Kanaphat4539/Security_Door_Lock/hardware/mainboard-min-handmade/JUMPERS.md

# Jumper wire list (single-sided build)

หลังกัดทองแดง F.Cu แล้ว ให้เดินสายไฟหุ้มฉนวนด้านบนบอร์ด (B.Cu)
ตามรายการนี้ สายกระโดดข้ามกันได้ (หุ้มฉนวน). จุดที่เป็น SMD pad
มีรูเจาะ (via) ให้ร้อยสายลงไปเชื่อม F.Cu.

| # | net | from | to | หมายเหตุ |
|---|-----|---|----|---|
| 1 | RFID_ENTRY_MOSI | U1.30 | J3.3 | เดินอ้อม |
| 2 | RELAY_CTRL | U1.9 | J8.3 | เดินอ้อม |
| 3 | CAM_RX2 | U1.21 | J7.4 | เดินอ้อม |
| 4 | RFID_EXIT_MOSI | U1.13 | J4.3 | สายตรง (ข้ามสายอื่น) |
| 5 | RFID_EXIT_SCK | U1.11 | J4.2 | สายตรง (ข้ามสายอื่น) |
| 6 | CAM_TX2 | U1.22 | J7.3 | เดินอ้อม |
| 7 | RFID_ENTRY_SS | U1.23 | J3.1 | สายตรง (ข้ามสายอื่น) |
| 8 | RFID_EXIT_MISO | U1.5 | J4.4 | สายตรง (ข้ามสายอื่น) |
| 9 | US_ECHO_3V3 | U1.6 | R6.2 | สายตรง (ข้ามสายอื่น) + via 1 จุด |
| 10 | +5V | U1.15 | J9.1 | สายตรง (ข้ามสายอื่น) |
| 11 | US_TRIG | U1.7 | J6.2 | สายตรง (ข้ามสายอื่น) |
| 12 | RFID_ENTRY_RST | U1.10 | J3.7 | สายตรง (ข้ามสายอื่น) |
| 13 | +5V | U1.15 | J6.1 | เดินอ้อม |
| 14 | BUZZER_CTRL | U1.8 | R8.1 | สายตรง (ข้ามสายอื่น) + via 1 จุด |
