Kanaphat4539/Security_Door_Lock/hardware/mainboard-min-handmade/handmade_top.png

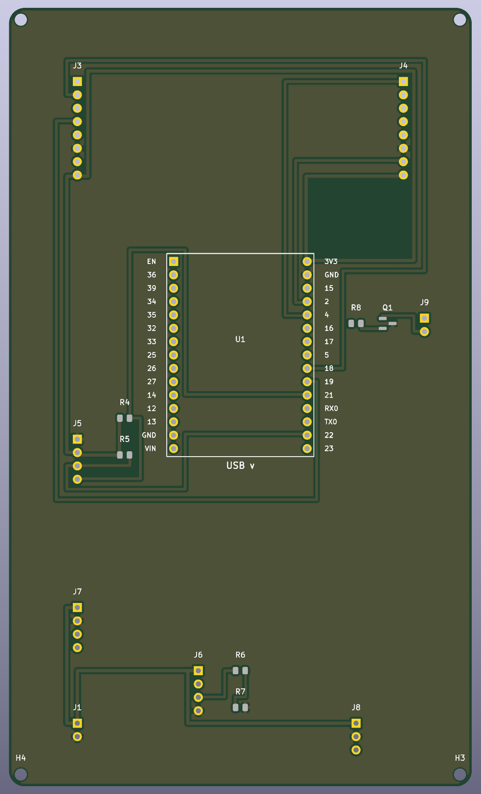
hardware/mainboard-min-handmade/handmade_top.png
