Kanaphat4539/Security_Door_Lock/hardware/mainboard-min-routed/routed_top.png

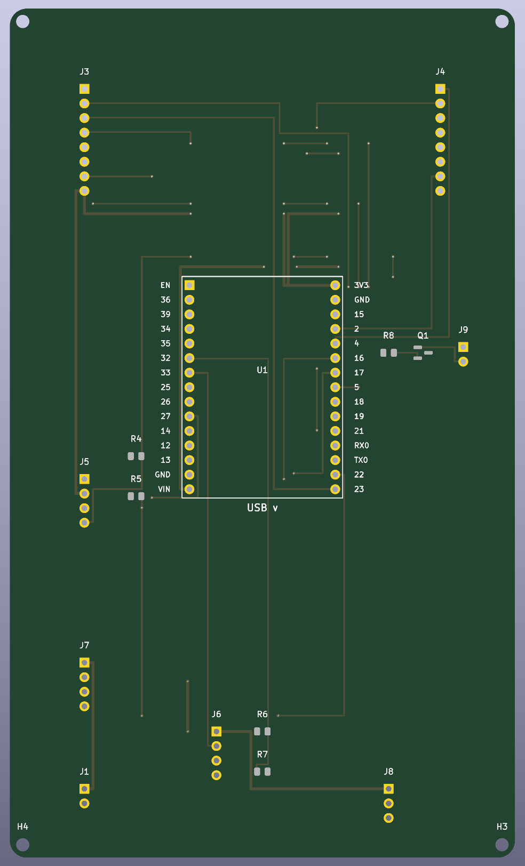
hardware/mainboard-min-routed/routed_top.png
