Kanaphat4539/Security_Door_Lock/hardware/mainboard/crop_power.png

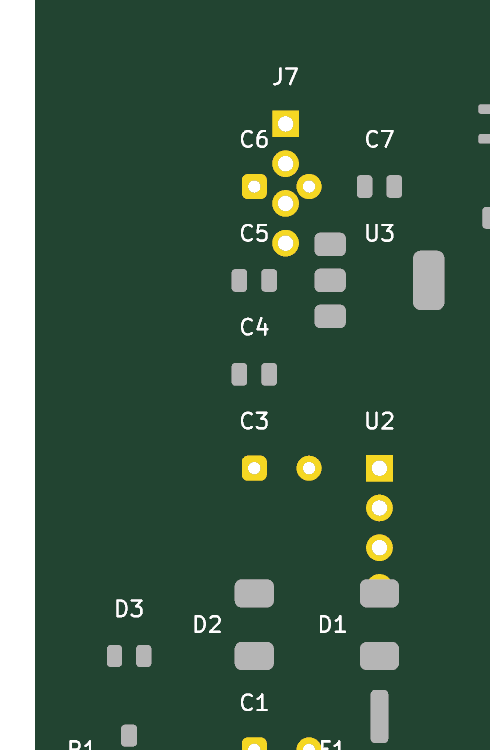
hardware/mainboard/crop_power.png
