Kanaphat4539/Security_Door_Lock/hardware/mainboard/crop_relay.png

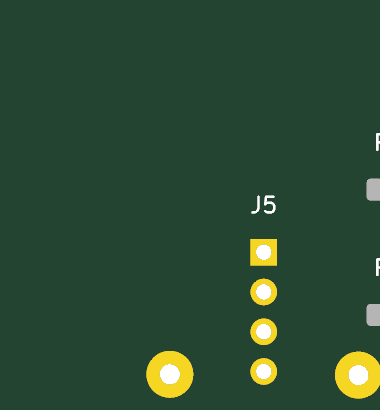
hardware/mainboard/crop_relay.png
