Kanaphat4539/Security_Door_Lock/hardware/mainboard/crop_right.png

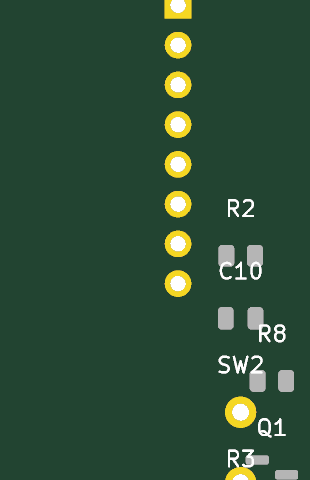
hardware/mainboard/crop_right.png
