Kanaphat4539/Security_Door_Lock/hardware/mainboard/placement_check.png

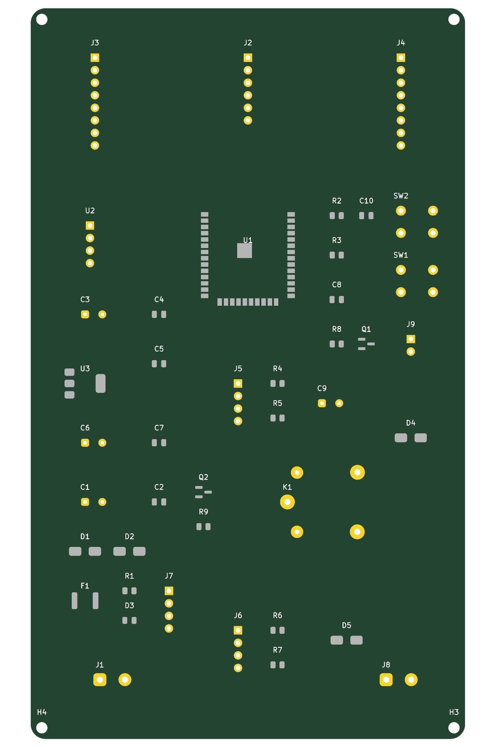
hardware/mainboard/placement_check.png
