Kanaphat4539/Security_Door_Lock/hardware/mainboard/routed_top.png

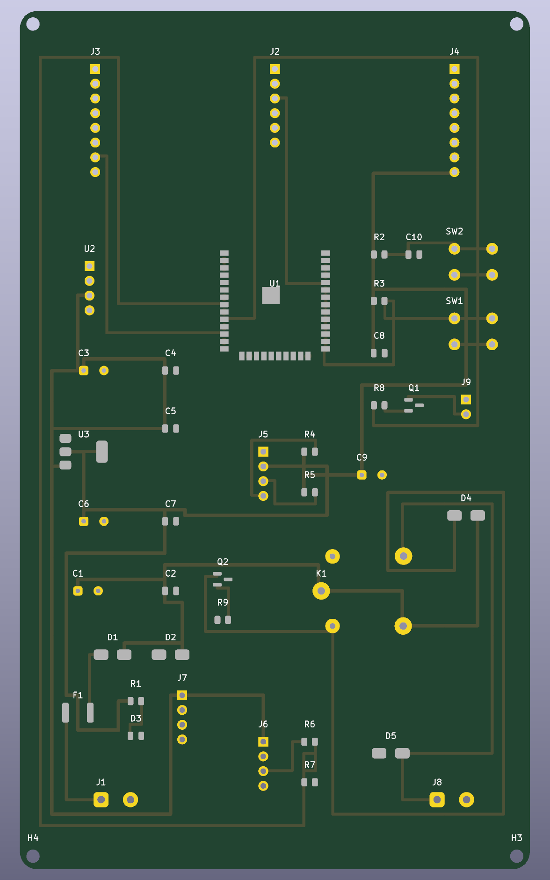
hardware/mainboard/routed_top.png
