Kanaphat4539/Security_Door_Lock/hardware_test_results.xlsx

Sheet: คำอธิบาย
ตารางผลการทดลองฮาร์ดแวร์ — ระบบล็อกประตูอัจฉริยะ RFID + กล้อง IoT
วิธีคำนวณค่าความผิดพลาด (Err %)
Err % = ( จำนวนครั้งที่ผิดพลาด ÷ จำนวนครั้งที่ทดสอบทั้งหมด ) × 100
โดย จำนวนครั้งที่ผิดพลาด = จำนวนครั้งที่ทดสอบทั้งหมด (N) − จำนวนครั้งที่สำเร็จ
ตัวอย่าง : ทดสอบ 10 ครั้ง สำเร็จ 9 ครั้ง → ผิดพลาด = 10 − 9 = 1 → Err % = 1/10 × 100 = 10.0%
• กรอกเฉพาะช่องสีเหลือง 2 ช่อง คือ "ครั้งทดสอบ (N)" และ "สำเร็จ"
• ช่อง "ผิดพลาด" และ "Err %" คำนวณให้อัตโนมัติด้วยสูตร (ห้ามพิมพ์ทับ)
• แนะนำทดสอบอย่างน้อย 10 ครั้ง/แถว (RFID และ End-to-end แนะนำ 20–30 ครั้ง) เพื่อให้ % น่าเชื่อถือ
• แถวรวมท้ายตาราง = ผลรวมทุกขั้นของกรณีนั้น (Err% รวม = Σผิดพลาด ÷ ΣN)
สัญลักษณ์สี
ช่องกรอกเอง (input) | #NAME?
ตัวอย่างการกรอก (แถวสาธิต — ไม่ใช่ข้อมูลจริง)
อุปกรณ์ | ครั้งทดสอบ (N) | สำเร็จ | ผิดพลาด | Err %
RFID #1 (สาธิต) | 10 | 9 | 1 | 10.0%

Sheet: 1_ขาเข้า-บัตรผ่าน
กรณีที่ 1 : ฝั่งขาเข้า (Entry) — บัตรผ่าน (granted)
ลำดับ | อุปกรณ์ | Input | Output ที่คาดหวัง | ครั้งทดสอบ (N) | สำเร็จ | ผิดพลาด | Err %
1 | Ultrasonic HY-SRF05 | เข้าใกล้ 100 cm (ระยะปลุกจอ) | WAKE → สั่งกล้องเปิด
2 | ESP32-CAM (จอ TFT) | คำสั่ง WAKE | เปิดจอ ST7735S + สตรีมภาพสด
3 | RFID RC522 #1 (เข้า) | ทาบบัตรที่ลงทะเบียน | อ่าน UID ถูกต้อง → ส่ง direction:in
4 | Backend /access | รับ JSON {uid, in} | ตอบ granted
5 | ESP32-CAM (/capture) | backend ดึงรูป | คืนไฟล์ JPEG ไม่เสีย
6 | OLED SH1106 | — | แสดงข้อความ "อนุญาต"
7 | Buzzer | — | เสียงสั้น 0.2 วินาที
8 | Relay + Solenoid Lock | — | ปลดล็อก 5 วินาที → ล็อกกลับ
9 | Dashboard (เรียลไทม์) | — | log + รูปขึ้นหน้าจอทันที
รวม |  |  |  | 0 | 0 | 0

Sheet: 2_ขาเข้า-บัตรไม่ผ่าน
กรณีที่ 2 : ฝั่งขาเข้า (Entry) — บัตรไม่ผ่าน (denied)
ลำดับ | อุปกรณ์ | Input | Output ที่คาดหวัง | ครั้งทดสอบ (N) | สำเร็จ | ผิดพลาด | Err %
1 | RFID RC522 #1 (เข้า) | ทาบบัตรแปลก/ปิดใช้งาน | อ่าน UID → ส่ง direction:in
2 | Backend /access | รับ JSON {uid, in} | ตอบ denied
3 | ESP32-CAM (/capture) | backend ดึงรูป | คืน JPEG เก็บเป็นหลักฐาน
4 | OLED SH1106 | — | แสดงข้อความ "ไม่อนุญาต"
5 | Buzzer | — | เสียงยาว 3 วินาที
6 | Relay + Solenoid Lock | — | คงสถานะล็อก (ประตูไม่เปิด)
7 | Dashboard (เรียลไทม์) | — | log สถานะ denied + รูปหลักฐาน
รวม |  |  |  | 0 | 0 | 0

Sheet: 3_ขาออก-บัตรผ่าน
กรณีที่ 3 : ฝั่งขาออก (Exit) — บัตรผ่าน (granted)
ลำดับ | อุปกรณ์ | Input | Output ที่คาดหวัง | ครั้งทดสอบ (N) | สำเร็จ | ผิดพลาด | Err %
1 | RFID RC522 #2 (ออก) | ทาบบัตรที่ลงทะเบียน | อ่าน UID → direction:out (ไม่ถ่ายรูป)
2 | Backend /access | รับ JSON {uid, out} | ตอบ granted (ไม่ดึงรูป)
3 | Buzzer | — | เสียงสั้น 1 ครั้ง
4 | Relay + Solenoid Lock | — | ปลดล็อก 5 วินาที → ล็อกกลับ
5 | Dashboard (เรียลไทม์) | — | log direction:out, imageUrl = null
รวม |  |  |  | 0 | 0 | 0

Sheet: 4_ขาออก-บัตรไม่ผ่าน
กรณีที่ 4 : ฝั่งขาออก (Exit) — บัตรไม่ผ่าน (denied)
ลำดับ | อุปกรณ์ | Input | Output ที่คาดหวัง | ครั้งทดสอบ (N) | สำเร็จ | ผิดพลาด | Err %
1 | RFID RC522 #2 (ออก) | ทาบบัตรแปลก/ปิดใช้งาน | อ่าน UID → ส่ง direction:out
2 | Backend /access | รับ JSON {uid, out} | ตอบ denied + เก็บ log
3 | Buzzer | — | เสียงยาว
4 | Relay + Solenoid Lock | — | คงสถานะล็อก
5 | Dashboard (เรียลไทม์) | — | log สถานะ denied, out
รวม |  |  |  | 0 | 0 | 0

Sheet: สรุปผล
สรุปผลการทดลอง 4 กรณี
กรณี | ทิศทาง | ผลบัตร | ผลลัพธ์ที่ต้องได้ | ครั้งทดสอบ | Err % รวม
1 | ขาเข้า | ผ่าน | ประตูเปิด + บันทึกรูป | 0
2 | ขาเข้า | ไม่ผ่าน | ประตูล็อก + เก็บรูปหลักฐาน | 0
3 | ขาออก | ผ่าน | ประตูเปิด (ไม่มีรูป) | 0
4 | ขาออก | ไม่ผ่าน | ประตูล็อก | 0
รวมทั้งหมด |  |  |  | 0
หมายเหตุ: Err % รวม = ผลรวมจำนวนครั้งที่ผิดพลาดทุกขั้น ÷ ผลรวมจำนวนครั้งที่ทดสอบทั้งหมด × 100
