Kanaphat4539/Security_Door_Lock/hardware/mainboard-min-handmade/PLACEMENT_guide.pdf

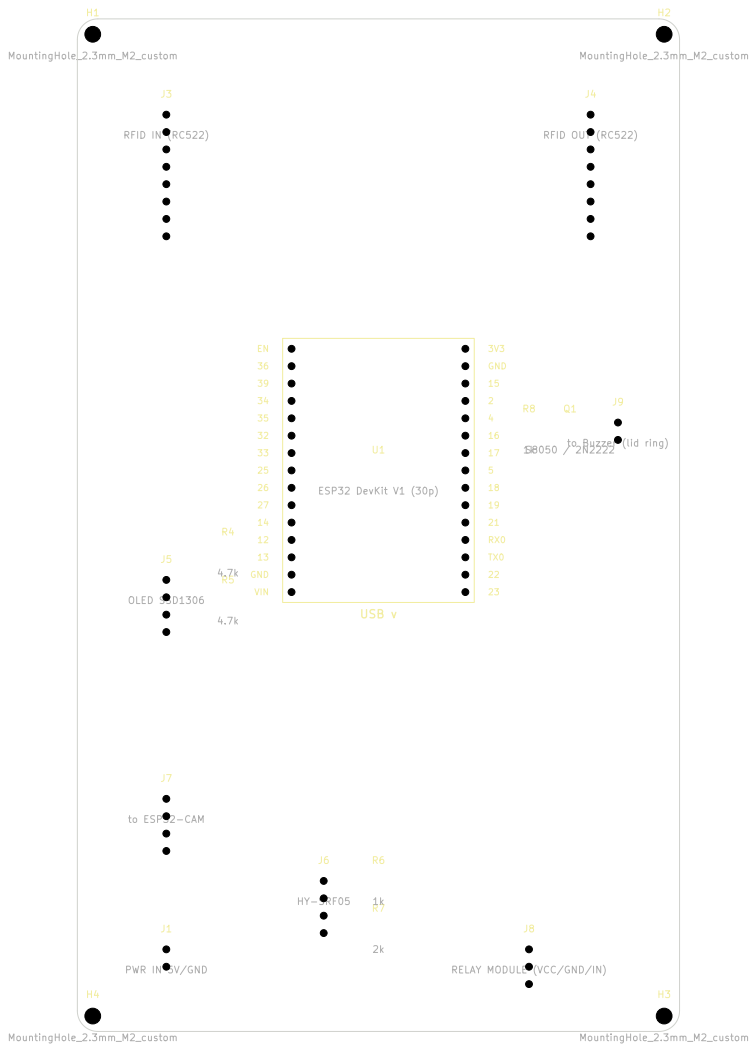
[picture p8: page 1]

RELAY MODULE (VCC/GND/IN) MountingHole_2.3mm_M2_custom
