Kanaphat4539/Security_Door_Lock/hardware/mainboard-min-handmade/copper_normal.pdf

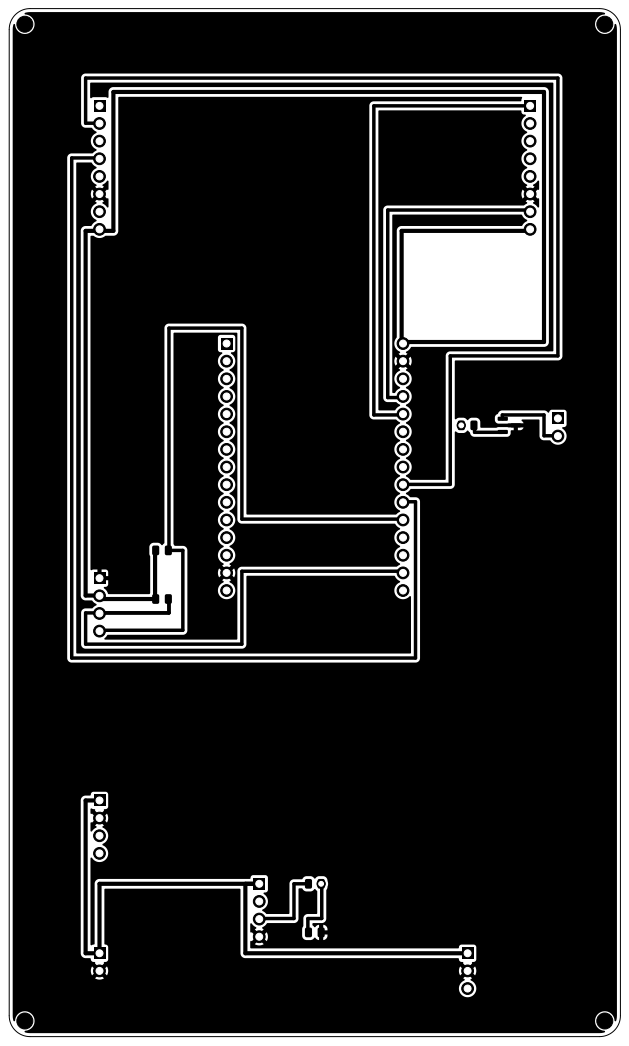
[picture p9: page 1]
