Kanaphat4539/Security_Door_Lock/hardware/mainboard-min-handmade/ETCH_copper_mirrored.pdf

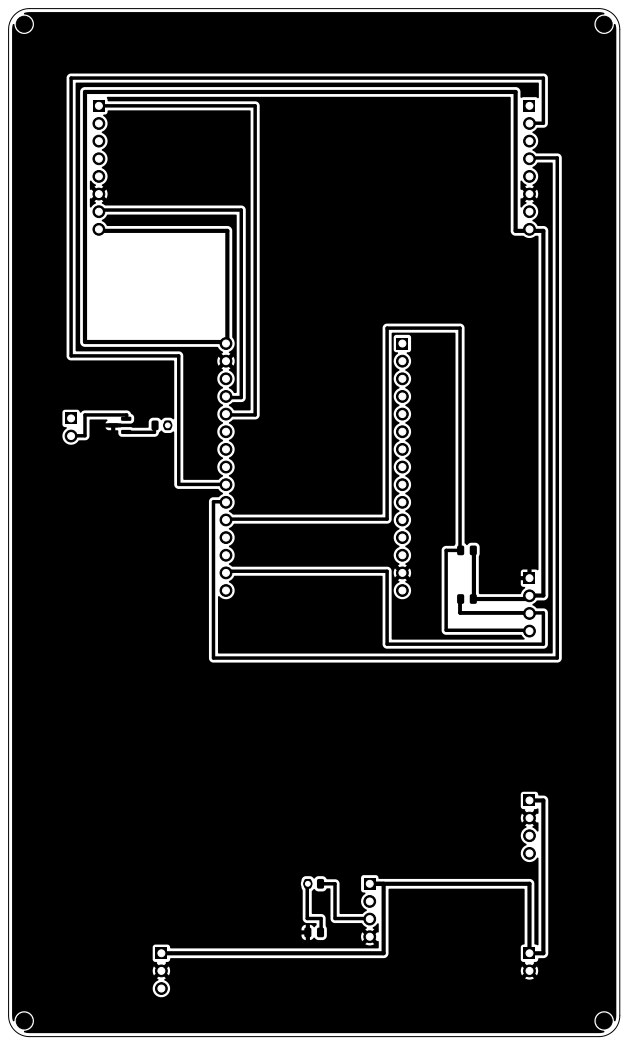
[picture p10: page 1]
