Kanaphat4539/Security_Door_Lock/hardware/mainboard-min-handmade/mainboard.kicad_pcb

## KiCad design hardware/mainboard-min-handmade/mainboard.kicad_pcb (2026-10-06)

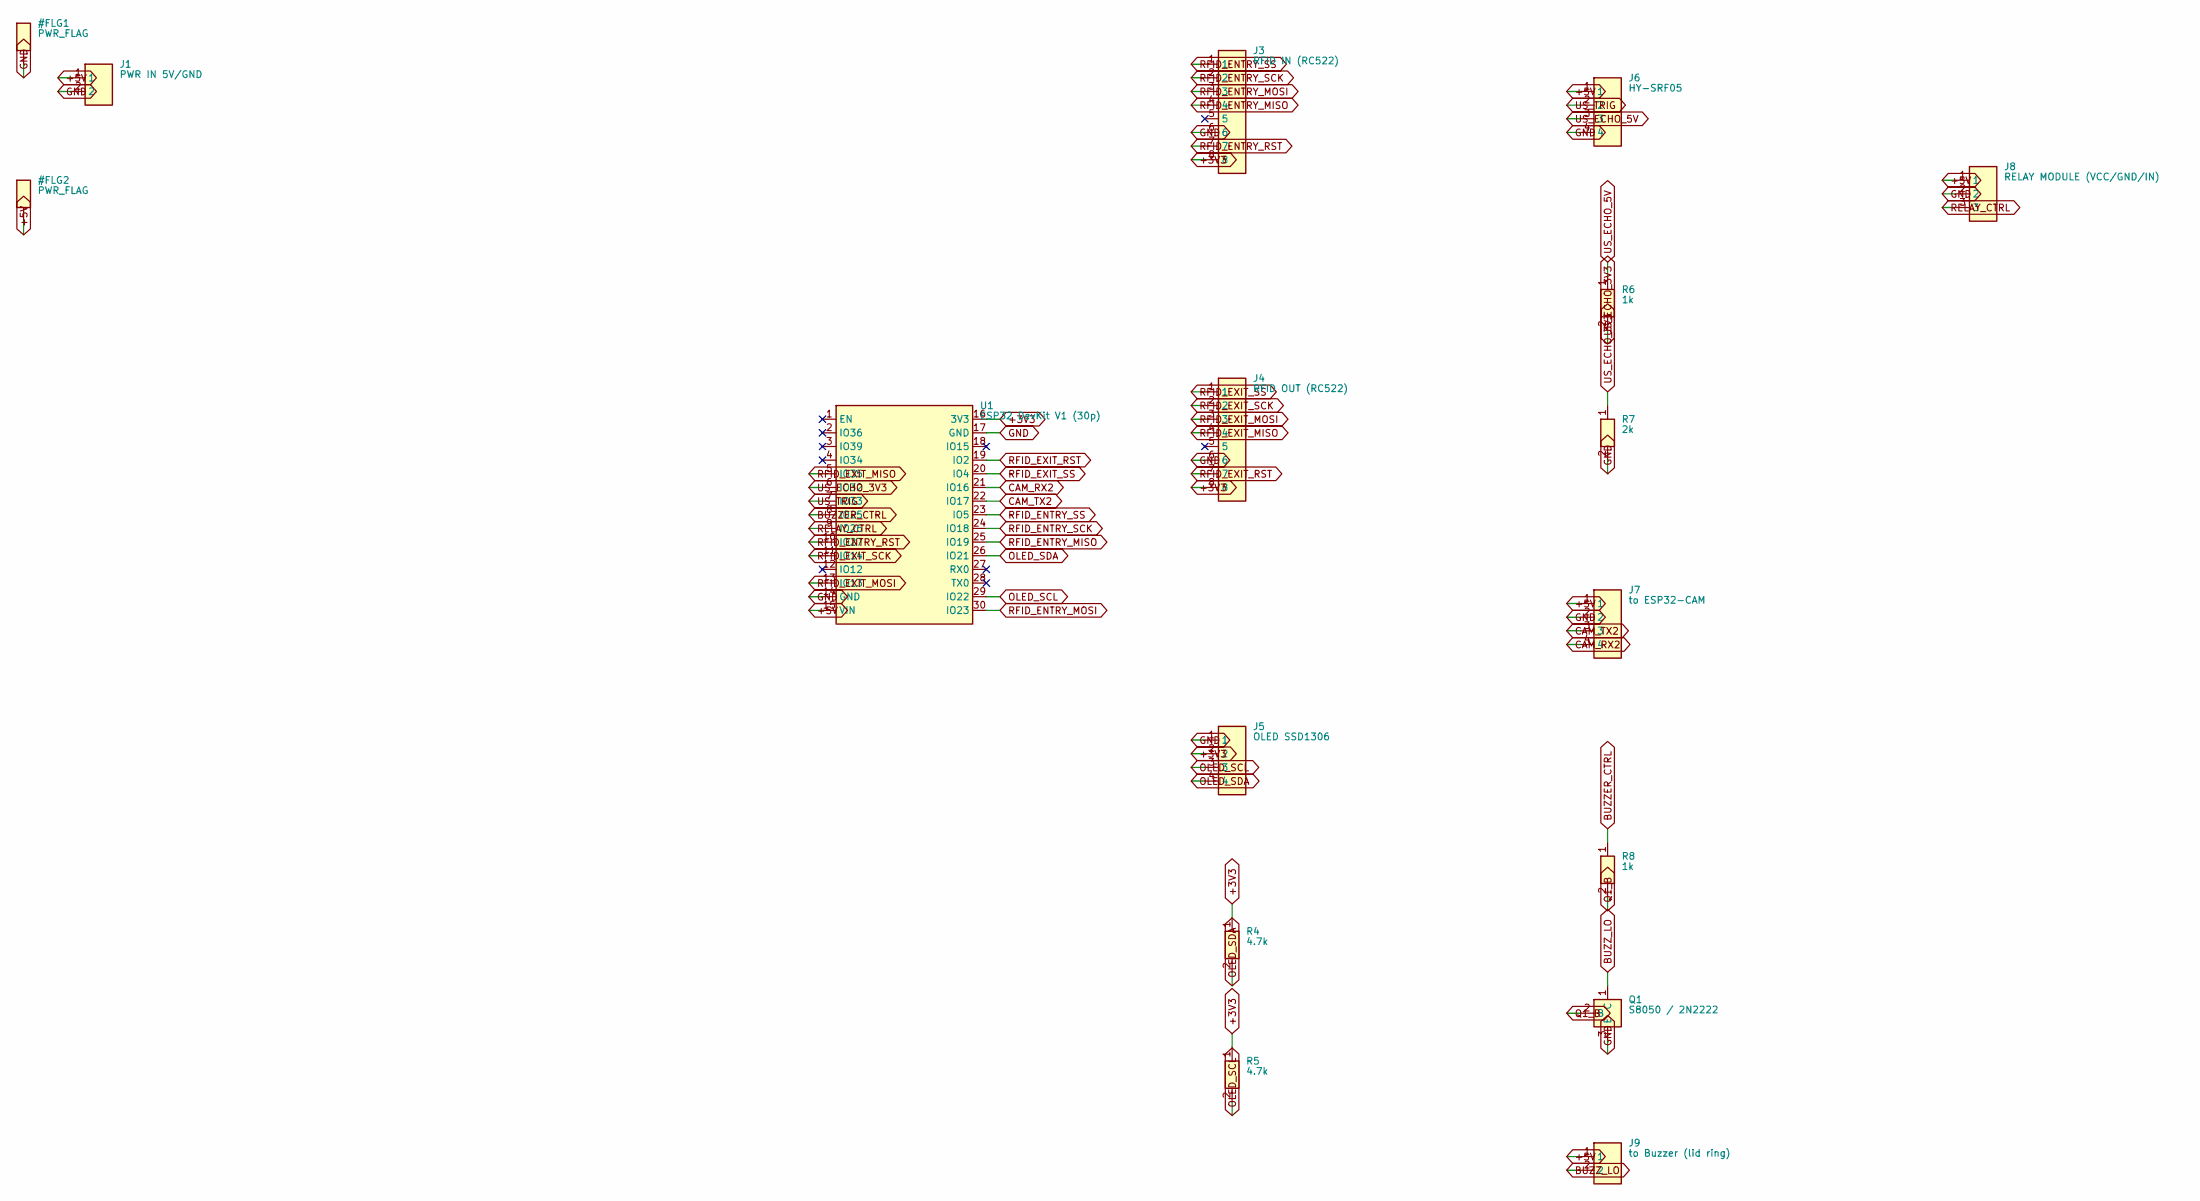
[picture p11: schematic mainboard.kicad_sch, Security Door Lock - Mainboard (ESP32 hub)]

Parts:
J1: PWR IN 5V/GND; PinHeader_1x02_P2.54mm_Vertical
J3: RFID IN (RC522); PinHeader_1x08_P2.54mm_Vertical
J4: RFID OUT (RC522); PinHeader_1x08_P2.54mm_Vertical
J5: OLED SSD1306; PinHeader_1x04_P2.54mm_Vertical
J6: HY-SRF05; PinHeader_1x04_P2.54mm_Vertical
J7: to ESP32-CAM; PinHeader_1x04_P2.54mm_Vertical
J8: RELAY MODULE (VCC/GND/IN); PinHeader_1x03_P2.54mm_Vertical
J9: to Buzzer (lid ring); PinHeader_1x02_P2.54mm_Vertical
Q1: S8050 / 2N2222; SOT-23
R4, R5: 4.7k; R_0805_2012Metric
R6, R8: 1k; R_0805_2012Metric
R7: 2k; R_0805_2012Metric
U1: ESP32 DevKit V1 (30p); ESP32-DevKitV1-30P_Socket

Connections:
+3V3: J3.8, J4.8, J5.2, R4.1, R5.1, U1.16 (3V3)
+5V: J1.1, J6.1, J7.1, J8.1, J9.1, U1.15 (VIN)
BUZZER_CTRL: R8.1, U1.8 (IO25)
BUZZ_LO: J9.2, Q1.1 (C)
CAM_RX2: J7.4, U1.21 (IO16)
CAM_TX2: J7.3, U1.22 (IO17)
GND: J1.2, J3.6, J4.6, J5.1, J6.4, J7.2, J8.2, Q1.3 (E), R7.2, U1.14 (GND), U1.17 (GND)
OLED_SCL: J5.3, R5.2, U1.29 (IO22)
OLED_SDA: J5.4, R4.2, U1.26 (IO21)
Q1_B: Q1.2 (B), R8.2
RELAY_CTRL: J8.3, U1.9 (IO26)
RFID_ENTRY_MISO: J3.4, U1.25 (IO19)
RFID_ENTRY_MOSI: J3.3, U1.30 (IO23)
RFID_ENTRY_RST: J3.7, U1.10 (IO27)
RFID_ENTRY_SCK: J3.2, U1.24 (IO18)
RFID_ENTRY_SS: J3.1, U1.23 (IO5)
RFID_EXIT_MISO: J4.4, U1.5 (IO35)
RFID_EXIT_MOSI: J4.3, U1.13 (IO13)
RFID_EXIT_RST: J4.7, U1.19 (IO2)
RFID_EXIT_SCK: J4.2, U1.11 (IO14)
RFID_EXIT_SS: J4.1, U1.20 (IO4)
US_ECHO_3V3: R6.2, R7.1, U1.6 (IO32)
US_ECHO_5V: J6.3, R6.1
US_TRIG: J6.2, U1.7 (IO33)

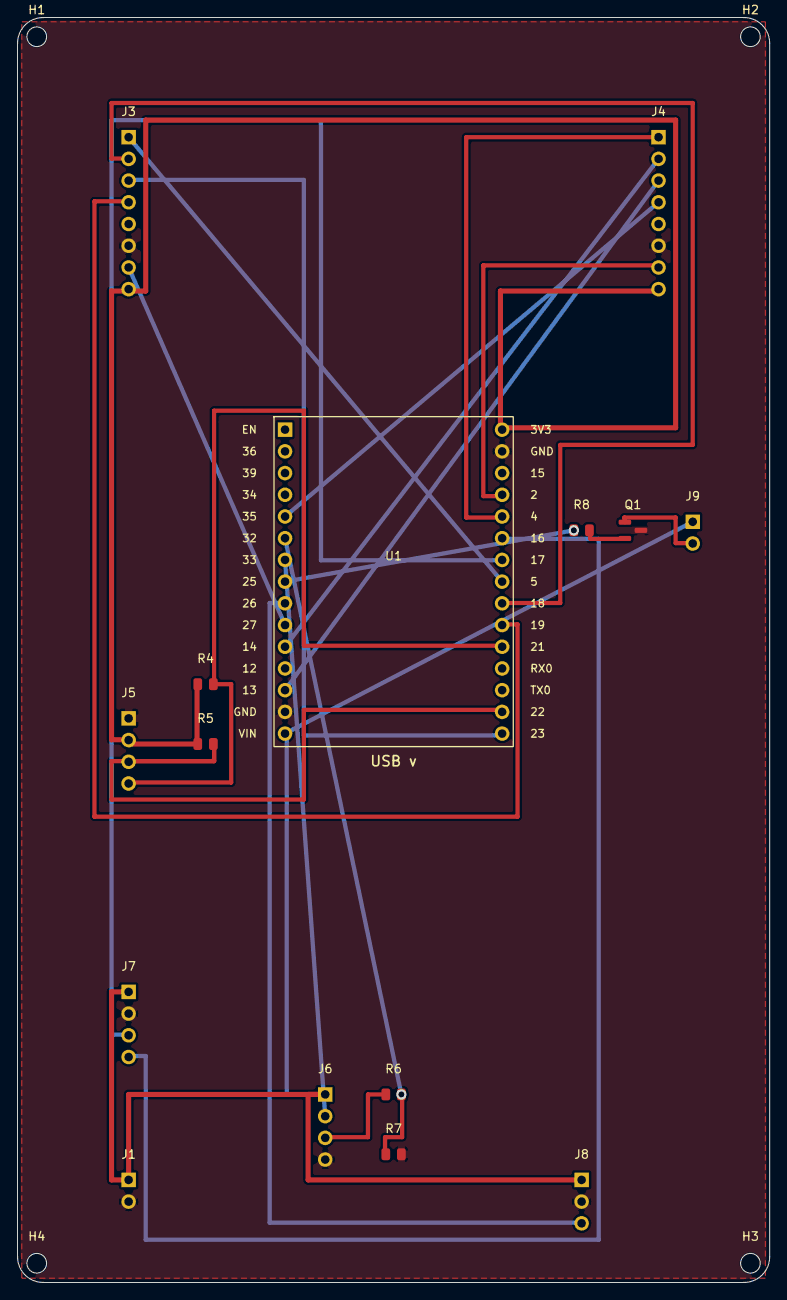
[picture p12: board hardware/mainboard-min-handmade/mainboard.kicad_pcb from above]

Board: 2 copper layers, 88.0 x 148.0 mm, 19 parts (0 on the bottom side), 24 nets.

Other parts of the board:
H1, H2, H3, H4: MountingHole_2.3mm_M2_custom
