Kanaphat4539/Security_Door_Lock/hardware/mainboard-2layer/mainboard.kicad_pcb

## KiCad design hardware/mainboard-2layer/mainboard.kicad_pcb (2026-10-06)

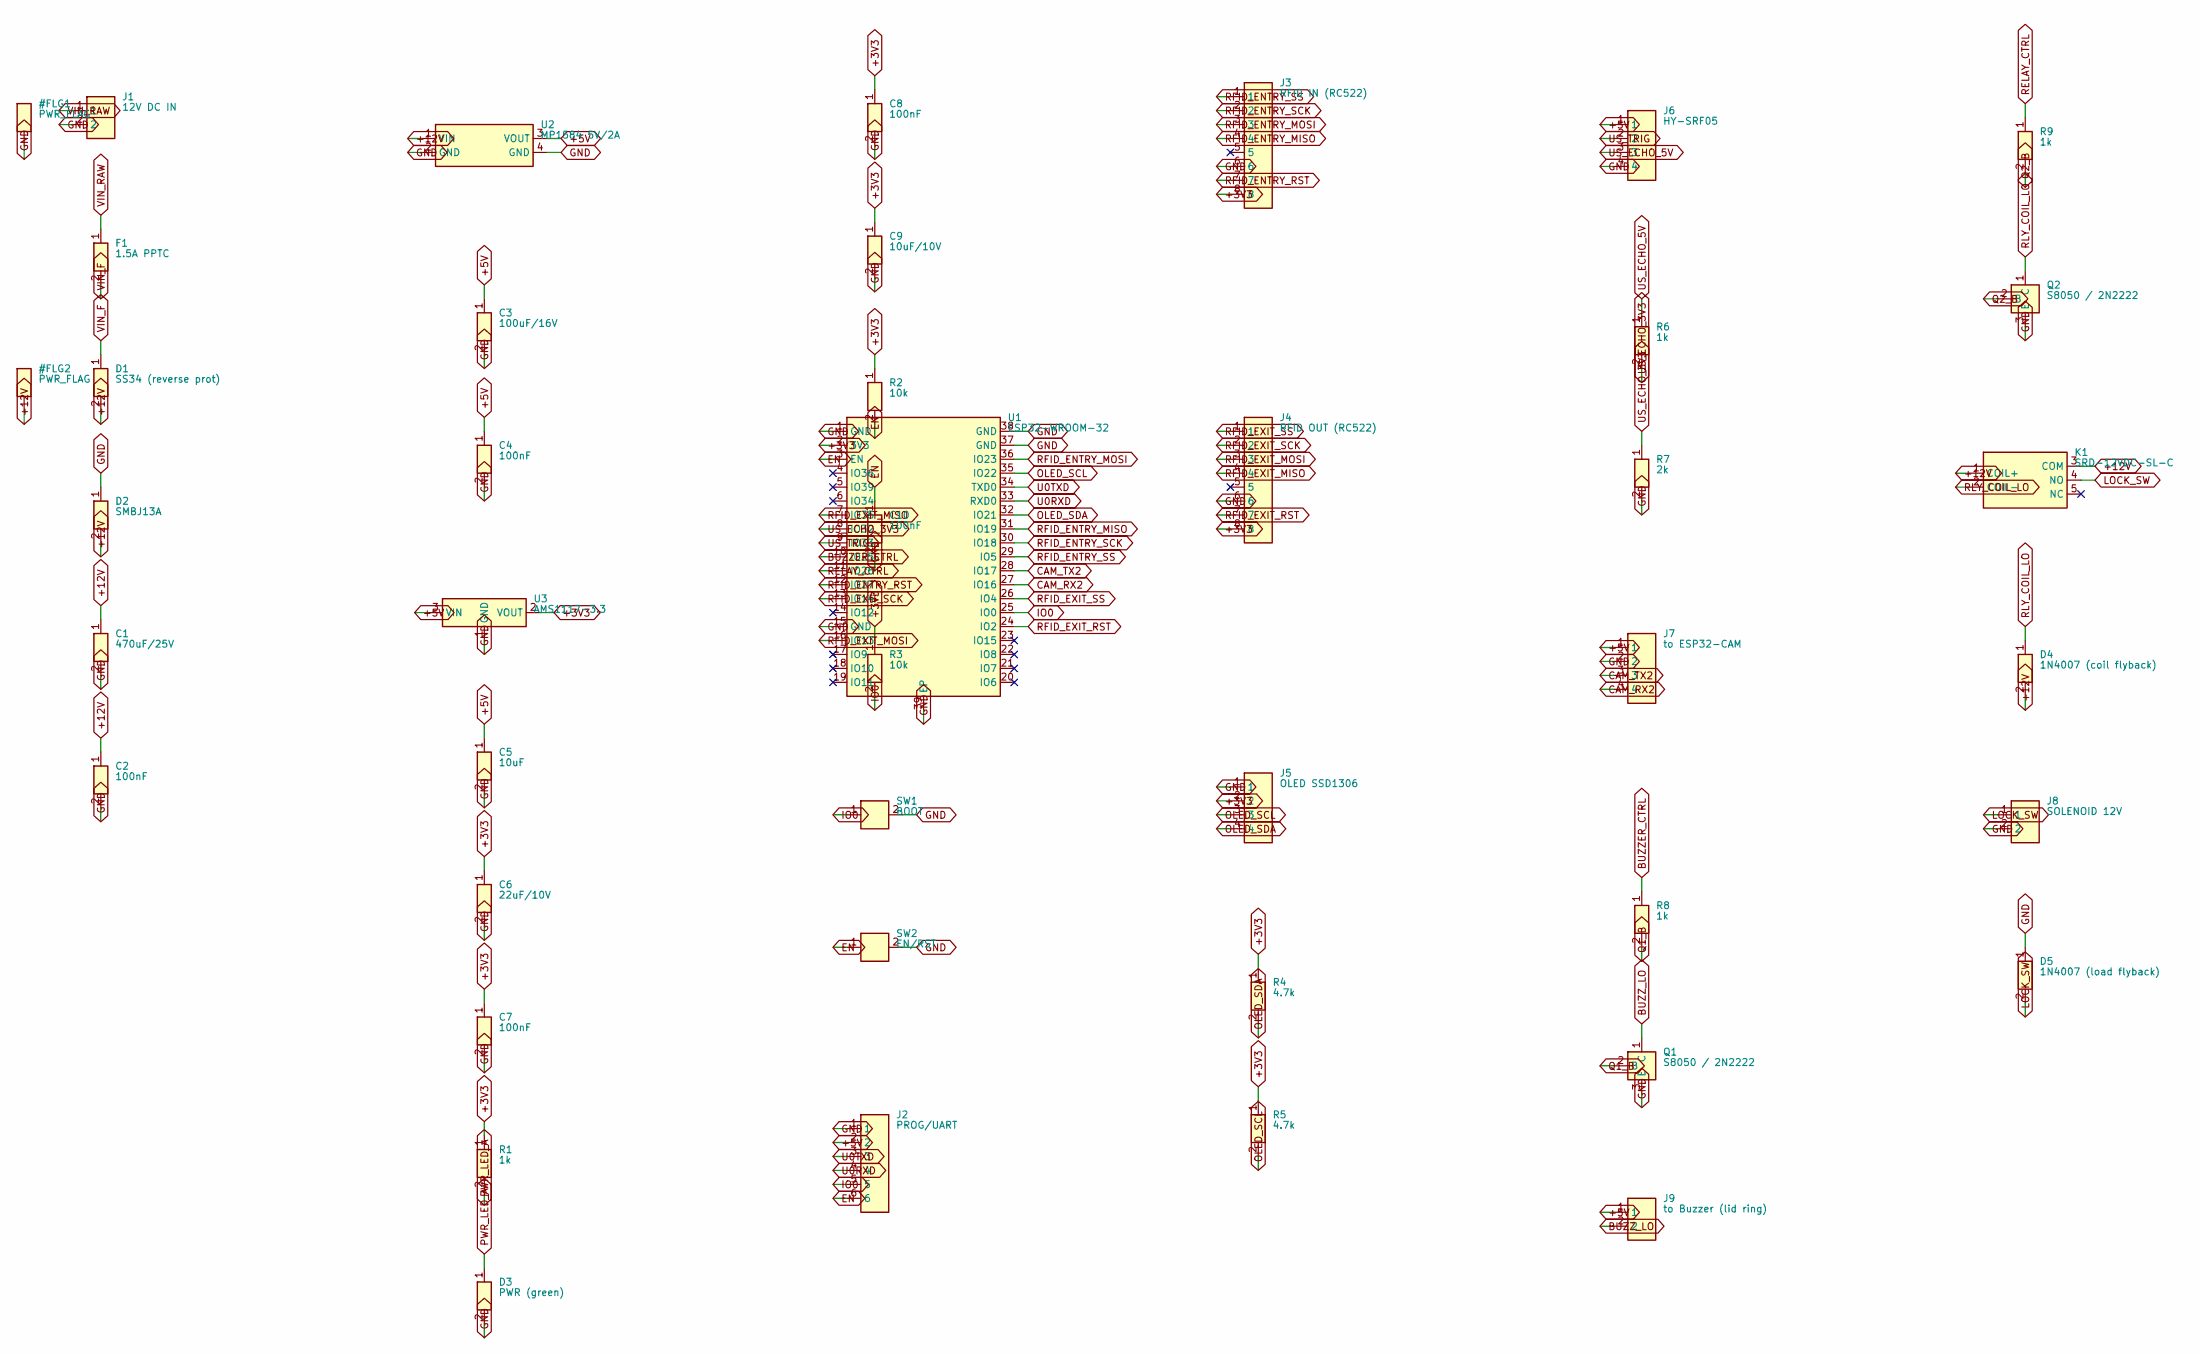
[picture p13: schematic mainboard.kicad_sch, Security Door Lock - Mainboard (ESP32 hub)]

Parts:
C1: 470uF/25V; CP_Radial_D8.0mm_P3.50mm
C2, C4, C7, C8, C10: 100nF; C_0805_2012Metric
C3: 100uF/16V; CP_Radial_D8.0mm_P3.50mm
C5: 10uF; C_0805_2012Metric
C6: 22uF/10V; CP_Radial_D8.0mm_P3.50mm
C9: 10uF/10V; CP_Radial_D8.0mm_P3.50mm
D1: SS34 (reverse prot); D_SMA
D2: SMBJ13A; D_SMA
D3: PWR (green); LED_0805_2012Metric
D4: 1N4007 (coil flyback); D_SMA
D5: 1N4007 (load flyback); D_SMA
F1: 1.5A PPTC; Fuse_1812_4532Metric
J1: 12V DC IN; TerminalBlock_Phoenix_MKDS-1,5-2-5.08_1x02_P5.08mm_Horizont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
J2: PROG/UART; PinHeader_1x06_P2.54mm_Vertical
J3: RFID IN (RC522); PinHeader_1x08_P2.54mm_Vertical
J4: RFID OUT (RC522); PinHeader_1x08_P2.54mm_Vertical
J5: OLED SSD1306; PinHeader_1x04_P2.54mm_Vertical
J6: HY-SRF05; PinHeader_1x04_P2.54mm_Vertical
J7: to ESP32-CAM; PinHeader_1x04_P2.54mm_Vertical
J8: SOLENOID 12V; TerminalBlock_Phoenix_MKDS-1,5-2-5.08_1x02_P5.08mm_Horizont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
J9: to Buzzer (lid ring); PinHeader_1x02_P2.54mm_Vertical
K1: SRD-12VDC-SL-C; Relay_SPDT_SANYOU_SRD_Series_Form_C
Q1, Q2: S8050 / 2N2222; SOT-23
R1, R6, R8, R9: 1k; R_0805_2012Metric
R2, R3: 10k; R_0805_2012Metric
R4, R5: 4.7k; R_0805_2012Metric
R7: 2k; R_0805_2012Metric
SW1: BOOT; SW_PUSH_6mm
SW2: EN/RST; SW_PUSH_6mm
U1: ESP32-WROOM-32
U2: MP1584 5V/2A; PinHeader_1x04_P2.54mm_Vertical
U3: AMS1117-3.3; SOT-223-3_TabPin2

Connections:
+3V3: C6.1 (+), C7.1, C8.1, C9.1 (+), J3.8, J4.8, J5.2, R1.1, R2.1, R3.1, R4.1, R5.1, U1.2 (3V3), U3.2 (VOUT)
+5V: C3.1 (+), C4.1, C5.1, J2.2, J6.1, J7.1, J9.1, U2.3 (VOUT), U3.3 (VIN)
+12V: C1.1 (+), C2.1, D1.2 (K), D2.2 (K), D4.2 (K), K1.1 (COIL+), K1.3 (COM), U2.1 (VIN)
BUZZER_CTRL: R8.1, U1.10 (IO25)
BUZZ_LO: J9.2, Q1.1 (C)
CAM_RX2: J7.4, U1.27 (IO16)
CAM_TX2: J7.3, U1.28 (IO17)
EN: C10.1, J2.6, R2.2, SW2.1, U1.3 (EN)
GND: C1.2 (-), C2.2, C3.2 (-), C4.2, C5.2, C6.2 (-), C7.2, C8.2, C9.2 (-), C10.2, D2.1 (A), D3.2 (K), D5.1 (A), J1.2, J2.1, J3.6, J4.6, J5.1, J6.4, J7.2, J8.2, Q1.3 (E), Q2.3 (E), R7.2, SW1.2, SW2.2, U1.1 (GND), U1.15 (GND), U1.37 (GND), U1.38 (GND), U1.39 (EP), U2.2 (GND), U2.4 (GND), U3.1 (GND)
IO0: J2.5, R3.2, SW1.1, U1.25 (IO0)
LOCK_SW: D5.2 (K), J8.1, K1.4 (NO)
OLED_SCL: J5.3, R5.2, U1.35 (IO22)
OLED_SDA: J5.4, R4.2, U1.32 (IO21)
PWR_LED_A: D3.1 (A), R1.2
Q1_B: Q1.2 (B), R8.2
Q2_B: Q2.2 (B), R9.2
RELAY_CTRL: R9.1, U1.11 (IO26)
RFID_ENTRY_MISO: J3.4, U1.31 (IO19)
RFID_ENTRY_MOSI: J3.3, U1.36 (IO23)
RFID_ENTRY_RST: J3.7, U1.12 (IO27)
RFID_ENTRY_SCK: J3.2, U1.30 (IO18)
RFID_ENTRY_SS: J3.1, U1.29 (IO5)
RFID_EXIT_MISO: J4.4, U1.7 (IO35)
RFID_EXIT_MOSI: J4.3, U1.16 (IO13)
RFID_EXIT_RST: J4.7, U1.24 (IO2)
RFID_EXIT_SCK: J4.2, U1.13 (IO14)
RFID_EXIT_SS: J4.1, U1.26 (IO4)
RLY_COIL_LO: D4.1 (A), K1.2 (COIL-), Q2.1 (C)
U0RXD: J2.4, U1.33 (RXD0)
U0TXD: J2.3, U1.34 (TXD0)
US_ECHO_3V3: R6.2, R7.1, U1.8 (IO32)
US_ECHO_5V: J6.3, R6.1
US_TRIG: J6.2, U1.9 (IO33)
VIN_F: D1.1 (A), F1.2
VIN_RAW: F1.1, J1.1

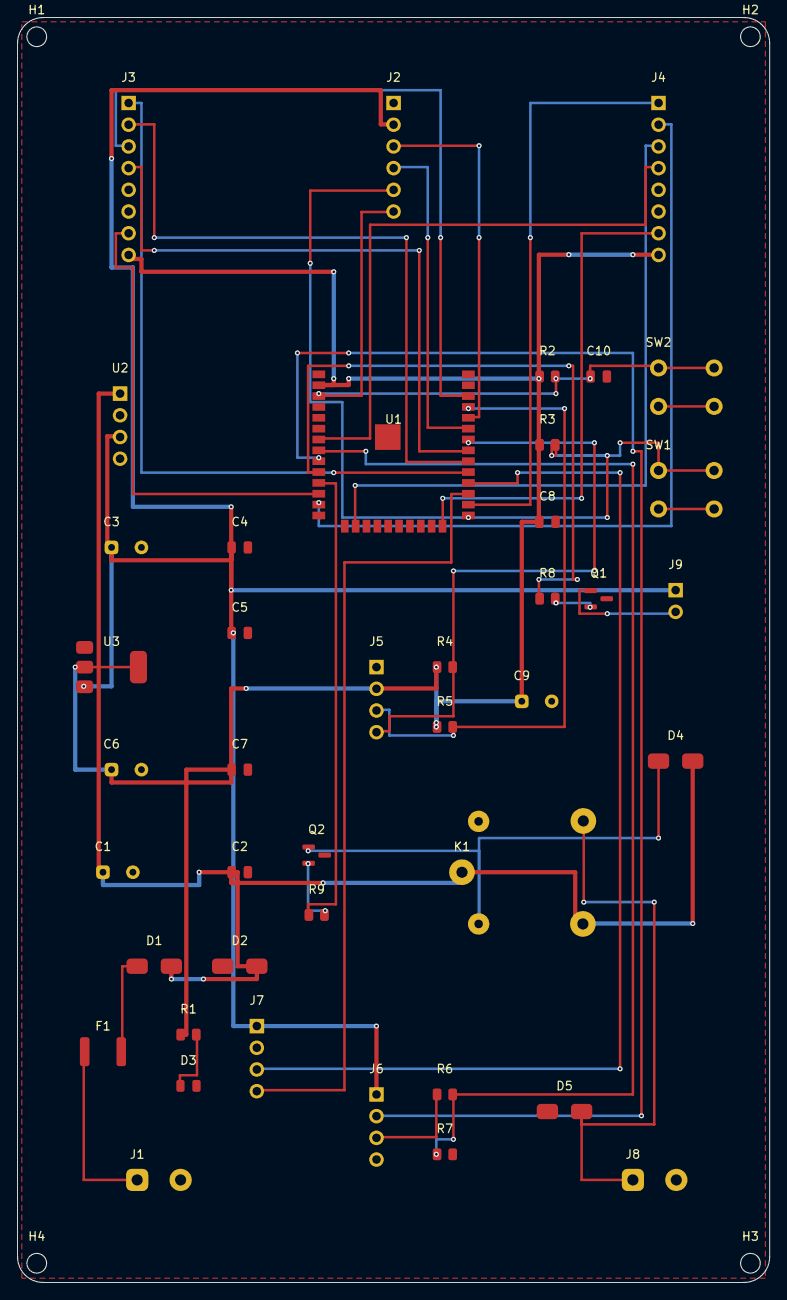
[picture p14: board hardware/mainboard-2layer/mainboard.kicad_pcb from above]

Board: 2 copper layers, 88.0 x 148.0 mm, 46 parts (0 on the bottom side), 35 nets.

Other parts of the board:
H1, H2, H3, H4: MountingHole_2.3mm_M2_custom
