Kanaphat4539/Security_Door_Lock/firmware/esp32-cam/src/esp32-cam/cam_settings.h

#pragma once

// ตั้งค่า WiFi และ Backend Server สำหรับ ESP32-CAM
constexpr char kWifiSsid[] = "thiraphat";
constexpr char kWifiPassword[] = "12345678";
constexpr char kServerBase[] = "http://192.168.137.1:3001";
constexpr char kDeviceToken[] = "a033222b56976a4d77ac32d427599ec16a2c71dac747df219475973a191ff4e5";
