Kanaphat4539/Security_Door_Lock/firmware/esp32-cam/examples/cam_dashboard_sleep/cam_settings.example.h

#pragma once
// Copy into cam_settings.h and set your LAN details. Never expose DEVICE_TOKEN in a browser URL.
constexpr char kWifiSsid[] = "YOUR_WIFI_SSID";
constexpr char kWifiPassword[] = "YOUR_WIFI_PASSWORD";
constexpr char kServerBase[] = "http://192.168.137.1:3001";
constexpr char kDeviceToken[] = "YOUR_DEVICE_TOKEN";
