Kanaphat4539/Security_Door_Lock/(commit log)

2026-07-20 feat: ย้ายระบบจาก repo Door มาใช้โครงสร้าง monorepo ของ Security_Door_Lock
    ยกโค้ดที่ทำงานได้จริงทั้งหมดจาก repo Door เข้ามาแทนที่โครงที่ยังไม่เสร็จ
    โดยคงโครงสร้างโฟลเดอร์แบบ apps/ + firmware แยกบอร์ดของ repo นี้ไว้
    - apps/backend: Nest.js (access, auth, users, events) + Prisma 7 + migrations
    - apps/frontend: Next.js 16 จัดไฟล์ใหม่ตาม convention ของ repo นี้
    lib/api,server-api -> services/ | T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
2026-07-20 feat(backend): เพิ่ม npm run setup สร้าง .env พร้อม token สุ่มอัตโนมัติ
    เพื่อนที่ clone repo มาจะได้รันคำสั่งเดียวแล้วใช้งานได้เลย ไม่ต้องนั่งกรอก
    token เอง และไม่ต้องไปขอค่าจากคนอื่น
    เลือกวิธีสุ่มแทนการ commit ค่าไว้ให้ เพราะ repo นี้เป็น public — ถ้า JWT_SECRET
    อยู่ใน git ใครก็ปลอม session เป็น ADMIN ได้ทันที DEVICE_T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
2026-07-20 fix(docker): เปลี่ยนชื่อ container และพอร์ต ไม่ให้ชนกับ repo Door
    repo Door ใช้ container `doorlock-mysql` จองพอร์ต 3306 อยู่ ซึ่งชื่อกับพอร์ต
    เดียวกันเป๊ะกับของที่นี่ (ย้ายไฟล์ compose มาตรง ๆ ตอน migrate) ทำให้เครื่องเดียว
    เปิด DB ของสองโปรเจกต์พร้อมกันไม่ได้ — docker ฟ้อง name conflict
    - container_name: doorlock-mysql -> securitydoor-mysql
    - host port: 3306 -> 3307 (ในคอน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
2026-08-01 fix(firmware): ย้าย MISO ของหัวอ่าน exit GPIO12 -> GPIO35 (แก้บอร์ดบูตค้าง)
    GPIO12 เป็น strapping pin (MTDI) ตั้งแรงดัน flash ตอนบูต โมดูล RC522 ดึงขึ้น HIGH
    ทำบอร์ดบูตค้างที่ load:... (เจอจริงตอนทดสอบฮาร์ดแวร์) ย้ายมา GPIO35 input-only
    + rfidBegin ลอง PCD_Init ซ้ำ 3 ครั้ง กัน log init failed หลอกตอนไฟยังไม่นิ่ง
    (port มาจาก repo Door)
2026-08-01 fix(backend): ปิดช่องโหว่ stored XSS ผ่านการอัปโหลดภาพ
    - บังคับนามสกุลไฟล์เป็น .jpg เสมอ ไม่เชื่อ originalname จากผู้ส่ง
    (เดิมคนมี DEVICE_TOKEN อัปไฟล์ .html มีสคริปต์ได้)
    - เสิร์ฟภาพด้วย Content-Type: image/jpeg + X-Content-Type-Options: nosniff
    ต่อให้มีไฟล์แปลกปลอมหลุด เบราว์เซอร์ก็ไม่รันเป็น HTML
    ทดสอบแล้ว: อัป evil.html -> เก็บเป็น .jpg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
2026-08-01 feat(backend): ปรับ /access เป็น Design B (main ต่อ WiFi เอง) + ดึงรูปจาก CAM
    flow ใหม่: ESP32 main ต่อ WiFi เอง POST /access เป็น JSON {uid, direction}
    รูปไม่มากับ request แล้ว — backend ไปดึงจาก ESP32-CAM เองตอนขาเข้า
    - /access รับ JSON {uid, direction} (ตัด multipart/FileInterceptor ออก)
    ตอบ {status} ทันที ประตูไม่รอโหลดรูป
    - module devices ใหม่:
    - POST /devices/cam/register — CAM รายงาน IP ตัวเองตอนบูต (DEVICE_TOKEN)
    - GET /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
2026-08-02 feat: initialize backend API architecture with Prisma, user authentication, and device management modules
2026-08-02 fix(backend): เพิ่ม allowPublicKeyRetrieval ใน DATABASE_URL (MySQL 8.4)
    driver mariadb ต่อ MySQL 8.4 (caching_sha2_password) แบบไม่มี TLS บน localhost
    ไม่ได้ -> ทุก DB query error 500 (RSA public key not available)
    เจอตอน volume ถูกสร้างใหม่ (docker compose down -v)
    แก้: setup-env.ts + .env.example ใส่ ?allowPublicKeyRetrieval=true ให้อัตโนมัติ
2026-08-02 feat(frontend): นำ UI ของ aniwat-ds มาใช้ + wire เข้ากับ backend เรา
    - นำ frontend ทั้งชุดจาก branch aniwat-ds มาแทน (UI ใหม่ + admin/employee sections)
    - สร้าง services/backend.ts เป็น layer กลาง คุย /auth /access /users + แปลง data
    (AccessAttempt ของเรา -> AccessLog ของ UI: granted->GRANTED, direction->doorId ฯลฯ)
    - แก้ base URL /api -> ไม่มี prefix (backend เราไม่มี /api)
    - auth: login/register เรียก /auth/login,/register จริง เก็บ JWT ใน localStorage
    + map role ADMIN->admin, USER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
2026-08-02 fix(backend): เปิด CORS ให้ frontend (aniwat) ยิงจากเบราว์เซอร์ตรงได้
    frontend ของ aniwat เป็น client-side (axios/socket.io จากเบราว์เซอร์) ต่างจาก
    nongtee เดิมที่ใช้ proxy ฝั่ง server — จึงต้องเปิด CORS ไม่งั้นโดน block หมด
    - main.ts: app.enableCors (dev สะท้อน origin ใดก็ได้, จำกัดผ่าน env CORS_ORIGIN)
    - events.gateway: WS cors permissive (ตั๋วคือด่านจริง ไม่ใช่ CORS)
    ทุก route ยังบังคับ Bea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
2026-08-04 docs: เพิ่มตารางผลการทดลอง hardware (Excel) พร้อมสูตรคำนวณ Err%
    ตารางบันทึกผลการทดสอบฮาร์ดแวร์แบบกรอกเอง แยกตาม 4 กรณี:
    ขาเข้า/ขาออก × บัตรผ่าน/ไม่ผ่าน โดยฝั่งขาเข้ามีขั้นตอนของกล้อง
    (WAKE/PRECAP/capture) ครบ ส่วนขาออกไม่ใช้กล้อง
    - ช่องกรอกเอง (สีเหลือง): ครั้งทดสอบ (N) + สำเร็จ
    - คำนวณอ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
    [hardware_test_results.xlsx]
2026-08-04 fix: update MySQL image to version 8.4 and implement thermal management in firmware
    [hardware_test_results.xlsx]
2026-09-13 feat: add SnapshotViewer component and integrate it into AdminLogsPage
    - Introduced SnapshotViewer component for displaying images with loading and error handling.
    - Integrated SnapshotViewer into AdminLogsPage to show snapshots for granted logs.
    - Updated ESP32 firmware configurations with new server URLs and device tokens.
    - Refactored code for improved readability and organization in both frontend and firmware files.
    [full-cam_test.ino, full-main_test.ino]
2026-09-15 feat(hardware): ESP32 mainboard PCBs (minimal DevKit variants) + wiring docs
    KiCad projects for the Security Door Lock mainboard, plus EasyEDA wiring
    guides. All GPIO maps verified 1:1 against firmware/esp32-main/config.h;
    ERC/DRC run with kicad-cli (KiCad 10).
    Boards (minimal = main devices only, external power, ESP32 DevKit V1 socket):
    - mainboard-min/ placed, unrouted "practice" board (route it yourself)
    - mainboard-min-routed/ 2-layer, fully routed, DRC-clean + JLCPCB gerber zip
    - mainboard-min-handmade/ single-sided (F.Cu) for home etching: toner-transfer
    PDFs + 14-wire JUMPERS list
    - mainboard-2layer/ earlier full mainboard (WROOM, 2-layer)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
    [mainboard-B_Cu.gbl, mainboard-B_Mask.gbs, mainboard-B_Paste.gbp, mainboard-B_Silkscreen.gbo, mainboard-Edge_Cuts.gbr, mainboard-Edge_Cuts.gm1, mainboard-F_Cu.gtl, mainboard-F_Mask.gts]
2026-09-15 Update wiring documentation and add PCB size specifications for Security Door Lock project
    - Revised wiring instructions in EASYEDA_WIRING_TH.md to reflect the actual firmware used and clarify connections for ESP32-CAM.
    - Added new BOARD_SIZE_TH.md file detailing PCB dimensions and mounting hole specifications for the mainboard.
    - Created a new WIRING_DIAGRAM.svg file to visually represent the wiring overview for the ESP-NOW firmware setup.
    - Included DRC report for mainboard highlighting footprint issues and mismatches for components.
2026-09-15 docs(hardware): consolidate EasyEDA guides into one start-to-finish file
    Merge the separate EasyEDA wiring / board-size / BOM notes into a single
    EASYEDA_GUIDE_TH.md that walks the whole PCB flow: new project → place
    parts → wire (ESP-NOW pin map) → convert to PCB (swap module footprints
    for pin headers so it fits the frame) → board outline + M2 holes →
    route → DRC → order gerbers. Appendices: BOM/LCSC, GPIO table, gotchas,
    troubleshooting.
    Removes EASYEDA_WIRING_TH.md, BOARD_SIZE_TH.md, EASYEDA_BOM_TH.md
    (content now lives in the single guide). WIRING_DIAGRAM.svg stays as the
    overview image, already corrected for the ESP-NOW (wireless camera,
    no TX/RX) firmware.
    Co-Authored-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
2026-09-15 docs(hardware): switch EasyEDA connectors from pin header to JST-XH
    Team standardised on JST-XH (2.5mm, keyed/locking) instead of 2.54mm
    male pin headers. Updated the guide's footprint table and BOM with the
    board-side connectors + verified LCSC codes:
    2P B2B-XH-A C158012 · 3P B3B-XH-A C144394 ·
    4P B4B-XH-A C144395 · 8P B8B-XH-A C157972
    Added the wire-side housings (XHP-n) and crimp terminal (SXH-001T,
    C144406), plus a note that the module ends stay 2.54mm dupont.
2026-09-15 docs(hardware): add current-calc / power-budget appendix to EasyEDA guide
    Explains why each resistor exists with the math: R8 base-current limit
    (2.6mA), R6/R7 ECHO 5V->3.3V divider (3.33V, 1.67mA), R4/R5 I2C pull-ups
    (0.70mA). Adds a per-device current table showing ~1A peak on the 5V
    rail, so the 12V->5V step-down should be rated >=1.5A.
2026-09-29 feat(line): update flex message layout to match FlexDoorlock design and handle logout flow
    [full-cam_test.ino, full-main_test.ino]
2026-10-04 feat(dashboard): add live camera section and update grid layout for stats
2026-10-06 feat(camera): report proximity without waking sensor
    Preserve existing device registration, access authorization, authentication and database architecture. Add authenticated presence notifications to admin and guard dashboards, with demand-driven camera viewing.
    Include a standalone CAM example with placeholder settings only. Targeted backend, frontend and firmware contract tests pass; hardware verification and existing full-project lint issues remain.
    [cam_dashboard_sleep.ino, cam_settings.example.h, test_cam_contract.py]
2026-10-06 fix(frontend): restore pooh dashboard layout with proximity alerts
    Restore original admin and guard layouts while retaining the presence notice and demand-driven camera behavior. Preserve truthful camera labels and add baseline layout regression tests. Frontend tests and production build passed; hardware verification remains pending.
2026-10-10 Refactor: Remove ESP32-CAM and main firmware files
    - Deleted main.cpp and related files for ESP32-CAM firmware, which handled camera operations, Wi-Fi connectivity, and HTTP requests.
    - Removed secrets.example.h to eliminate sensitive information handling.
    - Cleaned up ESP32 main firmware by deleting unnecessary files including platformio.ini, buzzer, display, relay, rfid, and ultrasonic modules.
    - Consolidated codebase by removing unused configurations and dependencies, streamlining the project structure.
2026-10-14 Refactor ESP32 firmware for door access control system
    - Reintroduced essential libraries for WiFi, HTTP, and JSON handling.
    - Updated WiFi and backend server configuration constants for clarity.
    - Enhanced ESP-NOW receiver address documentation.
    - Adjusted pin definitions for RFID readers and relay control.
    - Increased wake distance for ultrasonic sensor detection.
    - Improved command sending to ESP32-CAM for presence detection.
    - Streamlined access control logic and added comments for better understanding.
    - Implemented error handling for HTTP requests and notifications.
    - Added new Entity Relationship Diagram (ER-Diagram) for database structure.
    - Documented data dictionary for database ta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
2026-10-14 Refactor ESP32 main test code: streamline comments, improve ultrasonic detection logic, and enhance camera standby functionality
